Lyrux/gesture-glove/hardware/kicad/README.md

This directory is intended for KiCad project files
