Lyrux/gesture-glove/hardware/mechanical/stl/README.md

This directory is intended for .stl files
