Lyrux/gesture-glove/hardware/kicad/Gesture Glove/Gesture Glove.kicad_sch

## KiCad design hardware/kicad/Gesture Glove/Gesture Glove.kicad_sch (2026-10-27)

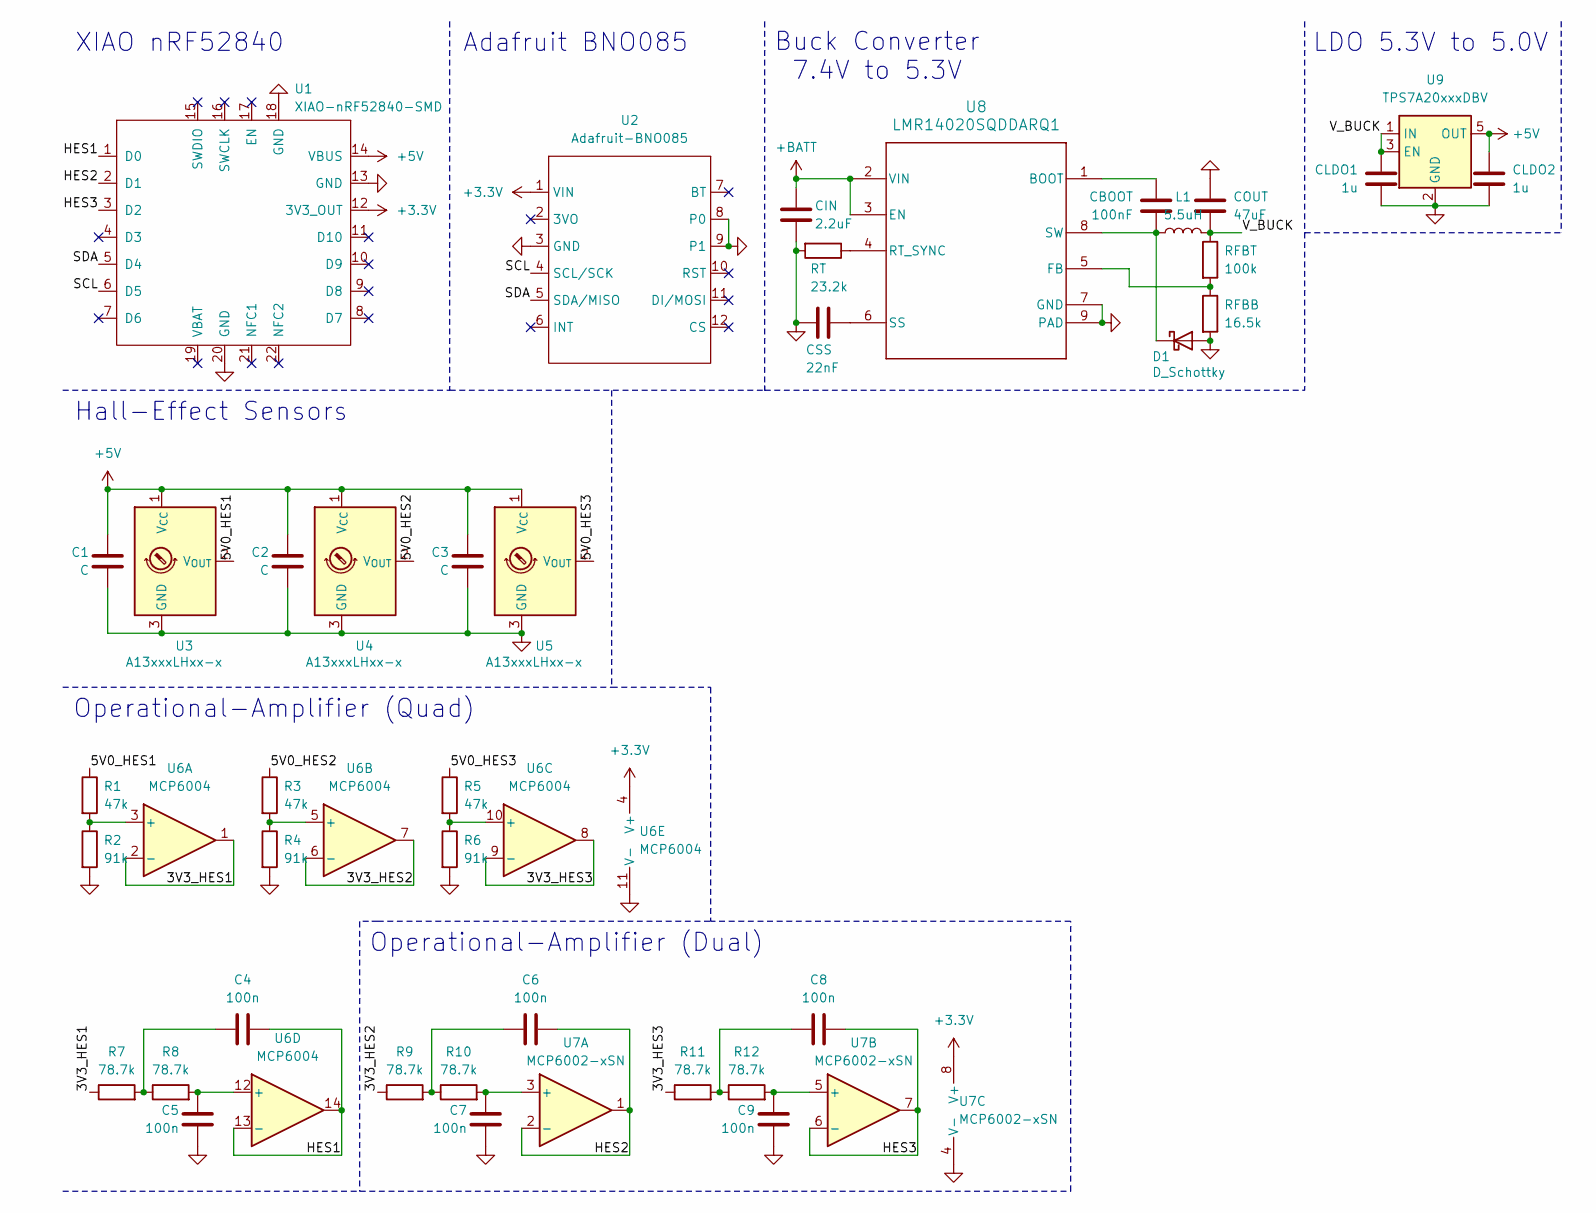
[picture p1: schematic Gesture Glove.kicad_sch]

Parts:
C1, C2, C3: C
C4, C5, C6, C7, C8, C9: 100n
CBOOT: 100nF
CIN: 2.2uF
CLDO1, CLDO2: 1u
COUT: 47uF
CSS: 22nF
D1: D_Schottky
L1: 5.5uH
R1, R3, R5: 47k
R2, R4, R6: 91k
R7, R8, R9, R10, R11, R12: 78.7k
RFBB: 16.5k
RFBT: 100k
RT: 23.2k
U1: XIAO-nRF52840-SMD
U2: Adafruit-BNO085
U3, U4, U5: A13xxxLHxx-x; SOT-23W
U6: MCP6004
U7: MCP6002-xSN
U8: LMR14020SQDDARQ1; DDA0008E_N
U9: TPS7A20xxxDBV; SOT-23-5

Connections:
3V3_HES1: R7.1, U6.1, U6.2 (-)
3V3_HES2: R9.1, U6.6 (-), U6.7
3V3_HES3: R11.1, U6.8, U6.9 (-)
5V0_HES1: R1.1, U3.2 (V_{OUT})
5V0_HES2: R3.1, U4.2 (V_{OUT})
5V0_HES3: R5.1, U5.2 (V_{OUT})
+3.3V: U1.12 (3V3_OUT), U2.1 (VIN), U6.4 (V+), U7.8 (V+)
+5V: C1.1, C2.1, C3.1, CLDO2.1, U1.14 (VBUS), U3.1 (V_{CC}), U4.1 (V_{CC}), U5.1 (V_{CC}), U9.5 (OUT)
+BATT: CIN.1, U8.2 (VIN), U8.3 (EN)
GND: C1.2, C2.2, C3.2, C5.2, C7.2, C9.2, CIN.2, CLDO1.2, CLDO2.2, COUT.1, CSS.2, D1.2 (A), R2.2, R4.2, R6.2, RFBB.2, RT.2, U1.13 (GND), U1.18 (GND), U1.20 (GND), U2.3 (GND), U2.8 (P0), U2.9 (P1), U3.3 (GND), U4.3 (GND), U5.3 (GND), U6.11 (V-), U7.4 (V-), U8.7 (GND), U8.9 (PAD), U9.2 (GND)
HES1: C4.2, U1.1 (D0), U6.13 (-), U6.14
HES2: C6.2, U1.2 (D1), U7.1, U7.2 (-)
HES3: C8.2, U1.3 (D2), U7.6 (-), U7.7
unnamed: C4.1, R7.2, R8.1
unnamed: C5.1, R8.2, U6.12 (+)
unnamed: C6.1, R9.2, R10.1
unnamed: C7.1, R10.2, U7.3 (+)
unnamed: C8.1, R11.2, R12.1
unnamed: C9.1, R12.2, U7.5 (+)
unnamed: CBOOT.1, U8.1 (BOOT)
unnamed: CBOOT.2, D1.1 (K), L1.1, U8.8 (SW)
unnamed: CSS.1, U8.6 (SS)
unnamed: R1.2, R2.1, U6.3 (+)
unnamed: R3.2, R4.1, U6.5 (+)
unnamed: R5.2, R6.1, U6.10 (+)
unnamed: RFBB.1, RFBT.2, U8.5 (FB)
unnamed: RT.1, U8.4 (RT_SYNC)
SCL: U1.6 (D5), U2.4 (SCL/SCK)
SDA: U1.5 (D4), U2.5 (SDA/MISO)
V_BUCK: CLDO1.1, COUT.2, L1.2, RFBT.1, U9.1 (IN), U9.3 (EN)

Notes on the sheet:
LDO 5.3V to 5.0V
Buck Converter 7.4V to 5.3V
Operational-Amplifier (Dual)
Adafruit BNO085
XIAO nRF52840
Operational-Amplifier (Quad)
Hall-Effect Sensors
