Lyrux/gesture-glove/hardware/mechanical/step/README.md

This directory is intended for .step files
