Lyrux/gesture-glove/firmware/src/main.cpp

#include <Arduino.h>
#include <Adafruit_TinyUSB.h> // Include the Adafruit TinyUSB library for serial functionality
#define HIDE_MACROS
#include "he_sensors.h"

void setup() {
	// put your setup code here, to run once:
	Serial.begin(115200);
	
	InitHESensors();
	
	Serial.println("time_ms,thumb,index,middle");
}

void loop() {
	// put your main code here, to run repeatedly:
	__WFE();

	unsigned long time = millis();
	
	HEData data = ReadHESensors();
	
	Serial.printf("%lu, %d, %d, %d\n", time, data.thumb, data.index, data.middle);
}
