Lyrux/gesture-glove/(commit log)

2026-09-27 Update main.cpp
    correction to time calculation in comments
    [main.cpp]
2026-09-29 tested HE sensors with nRF52840 via serial monitor
2026-09-30 Create saadc-dma
2026-09-30 Update and rename saadc-dma to saadc_dma.cpp
2026-09-30 Declaration error fixes
    Fixed incompatibility with gnu compiler standards in platform io
    [he_sensors.cpp, he_sensors.h, saadc_config.cpp]
2026-10-01 Power Consumption Reduction and Function Call Syntax Changes
2026-10-01 Revert "Naming Convention Fixes"
    This reverts commit 8261d986e1c6faf6f708a3b8793ca9c8706950ab.
    [he_sensors.cpp, he_sensors.h, main.cpp]
2026-10-01 Sample Frequency Macro
2026-10-02 Doxygen Documentation & Macro Fixes
    Made CHANNEL_NUM accurately configure channel registers dynamically in init function for future expansion. Added documentation on function behaviour according to Doxygen standards.
    [he_sensors.cpp, he_sensors.h, saadc_config.cpp, saadc_isr.cpp]
2026-10-05 Changed Naming Convention of Preprocessor Macros
    This change will hopefully prevent future naming collisions.
    [he_sensors.cpp, he_sensors.h, saadc_config.cpp]
2026-10-05 Force Blocked HES Macro Definition in Main
    Used #ifndef to prevent preprocessor from reading HES exclusive definitions in main. HIDE_MACROS can be used to similarly block macros from other subsystems.
    [he_sensors.cpp, he_sensors.h, main.cpp, saadc_config.cpp]
2026-10-05 Updated Documentation on ADC Reference
2026-10-27 Update Gesture Glove.kicad_sch
